liquid-rocketry-illinois/HAL-1-GND/KC_proj/KC_proj.kicad_pcb

## KiCad design KC_proj/KC_proj.kicad_pcb (2026-05-08)

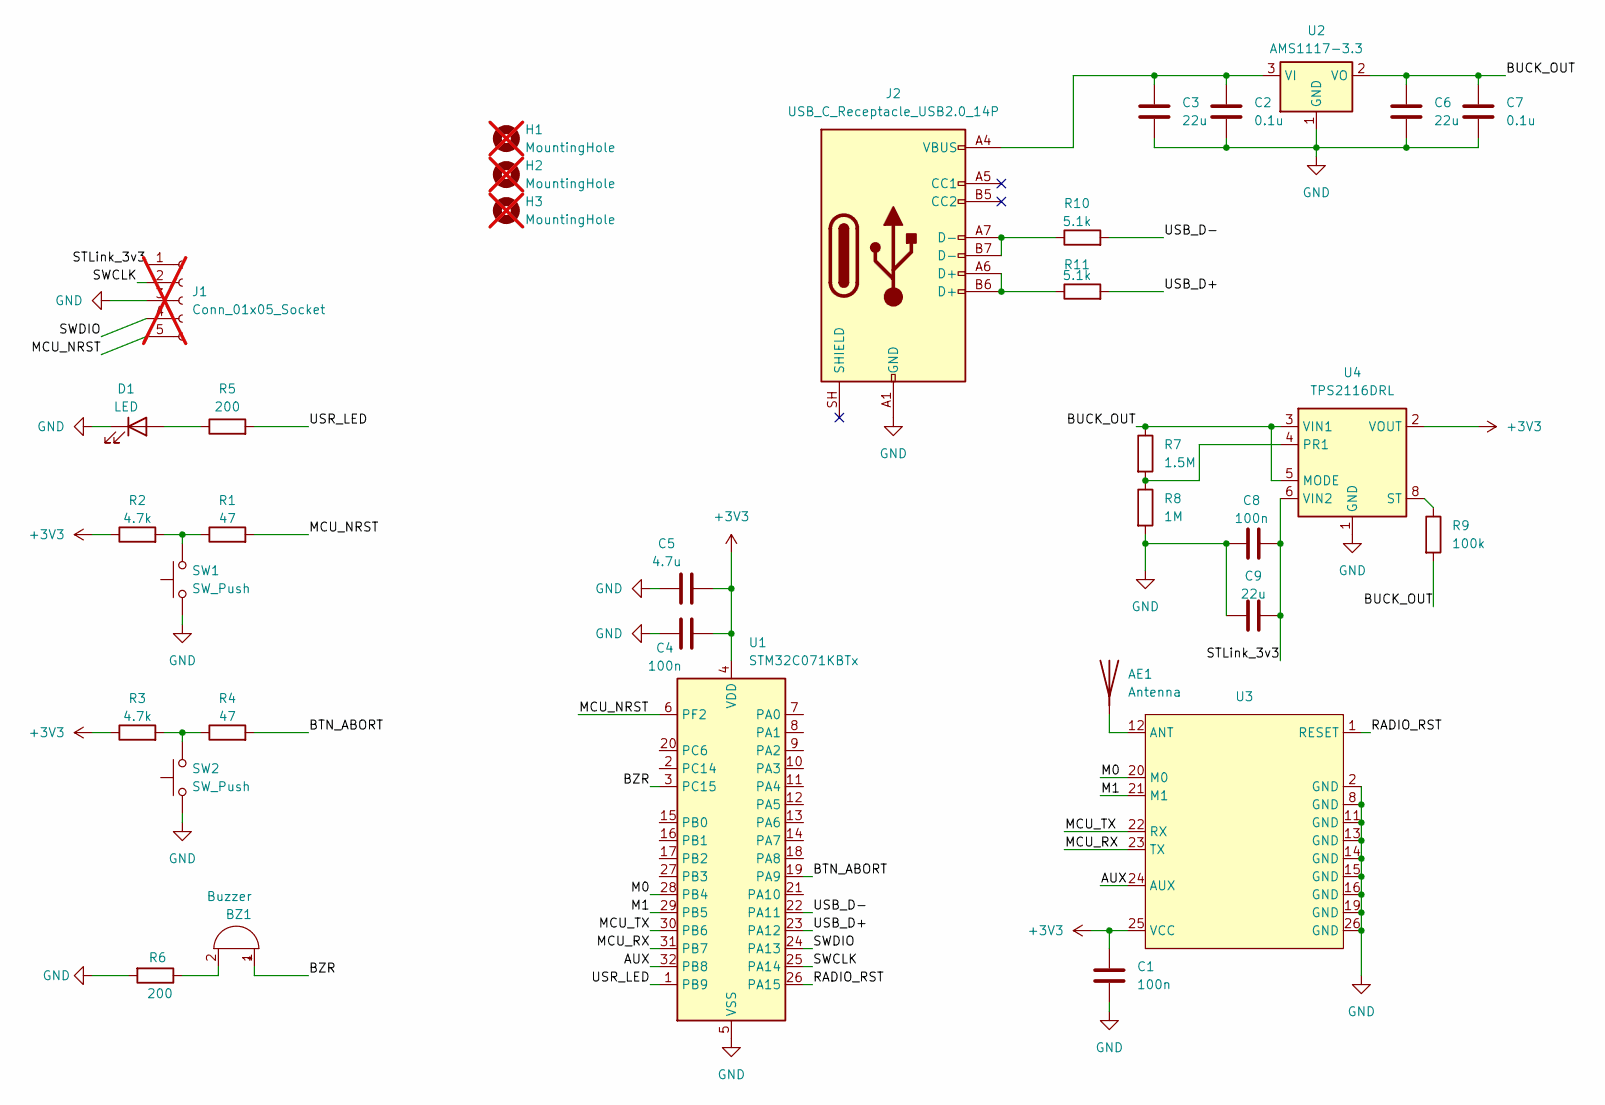
[picture p1: schematic KC_proj.kicad_sch]

Parts:
AE1: Antenna; SMA_Amphenol_901-143_Horizontal
BZ1: Buzzer; Buzzer_12x9.5RM7.6
C1, C4, C8: 100n; C_0603_1608Metric
C2, C7: 0.1u; C_0603_1608Metric
C3, C6, C9: 22u; C_0603_1608Metric
C5: 4.7u; C_0603_1608Metric
D1: LED; LED_0603_1608Metric
H1, H2, H3: MountingHole; MountingHole_2.2mm_M2; not fitted
J1: Conn_01x05_Socket; PinHeader_1x05_P2.54mm_Vertical; not fitted
J2: USB_C_Receptacle_USB2.0_14P; USB_C_Receptacle_HRO_TYPE-C-31-M-12
R1, R4: 47; R_0603_1608Metric
R2, R3: 4.7k; R_0603_1608Metric
R5, R6: 200; R_0603_1608Metric
R7: 1.5M; R_0603_1608Metric
R8: 1M; R_0603_1608Metric
R9: 100k; R_0603_1608Metric
R10, R11: 5.1k; R_0603_1608Metric
SW1, SW2: SW_Push; SW_Push_1P1T_NO_CK_KSC6xxJ
U1: STM32C071KBTx; LQFP-32_7x7mm_P0.8mm
U2: AMS1117-3.3; SOT-223-3_TabPin2
U3: E22-900T22S
U4: TPS2116DRL; SOT-583-8

Connections:
+3V3: C1.1, C4.2, C5.2, R2.1, R3.1, U1.4 (VDD), U3.25 (VCC), U4.2 (VOUT), U4.7 (VOUT)
/AUX: U1.32 (PB8), U3.24 (AUX)
/BTN_ABORT: R4.2, U1.19 (PA9)
/BUCK_OUT: C6.1, C7.1, R7.1, R9.2, U2.2 (VO), U4.3 (VIN1), U4.5 (MODE)
/BZR: BZ1.1 (+), U1.3 (PC15)
/M0: U1.28 (PB4), U3.20 (M0)
/M1: U1.29 (PB5), U3.21 (M1)
/MCU_NRST: J1.5, R1.2, U1.6 (PF2)
/MCU_RX: U1.31 (PB7), U3.23 (TX)
/MCU_TX: U1.30 (PB6), U3.22 (RX)
/RADIO_RST: U1.26 (PA15), U3.1 (RESET)
/STLink_3v3: C8.2, C9.2, J1.1, U4.6 (VIN2)
/SWCLK: J1.2, U1.25 (PA14)
/SWDIO: J1.4, U1.24 (PA13)
/USB_D+: R11.2, U1.23 (PA12)
/USB_D-: R10.2, U1.22 (PA11)
/USR_LED: R5.2, U1.1 (PB9)
GND: C1.2, C2.2, C3.2, C4.1, C5.1, C6.2, C7.2, C8.1, C9.1, D1.1 (K), J1.3, J2.A1 (GND), J2.A12 (GND), J2.B1 (GND), J2.B12 (GND), R6.2, R8.2, SW1.1, SW2.1, U1.5 (VSS), U2.1 (GND), U3.2 (GND), U3.8 (GND), U3.11 (GND), U3.13 (GND), U3.14 (GND), U3.15 (GND), U3.16 (GND), U3.19 (GND), U3.26 (GND), U4.1 (GND)
unnamed: AE1.1 (A_1), U3.12 (ANT)
unnamed: BZ1.2 (-), R6.1
unnamed: D1.2 (A), R5.1
unnamed: J2.A6 (D+), J2.B6 (D+), R11.1
unnamed: J2.A7 (D-), J2.B7 (D-), R10.1
unnamed: R1.1, R2.2, SW1.2
unnamed: R3.2, R4.1, SW2.2
unnamed: C2.1, C3.1, J2.A4 (VBUS), J2.A9 (VBUS), J2.B4 (VBUS), J2.B9 (VBUS), U2.3 (VI)
unnamed: R7.2, R8.1, U4.4 (PR1)
unnamed: R9.1, U4.8 (ST)

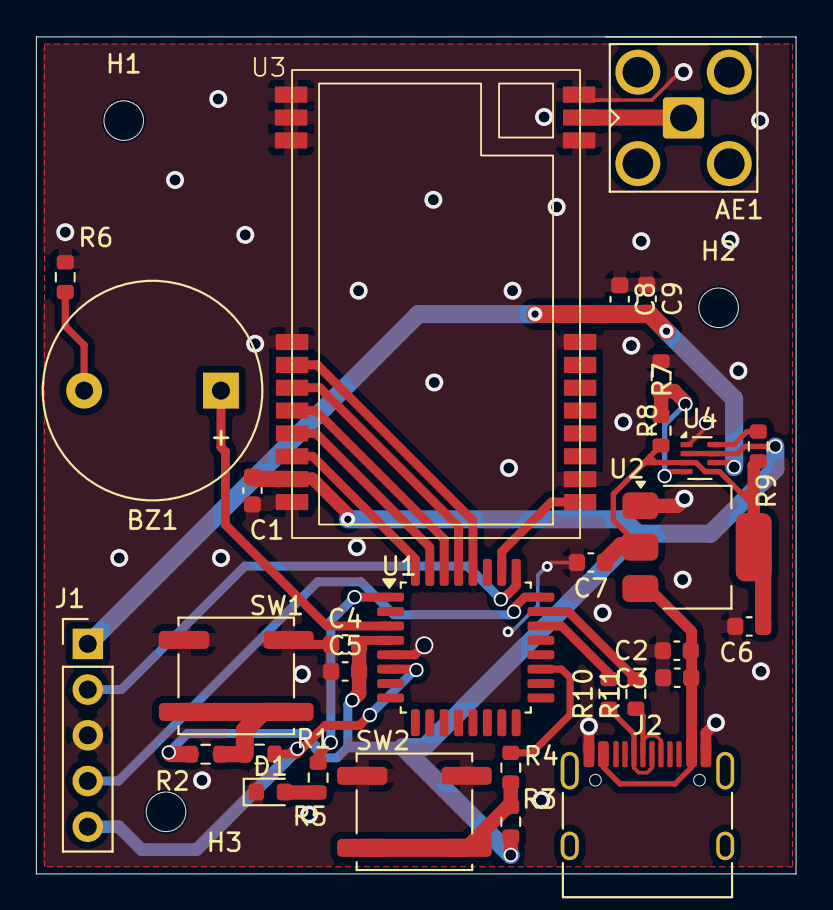
[picture p2: board KC_proj.kicad_pcb from above]

Board: 2 copper layers, 42.2 x 46.5 mm, 34 parts (0 on the bottom side), 28 nets.
