liquid-rocketry-illinois/HAL-1-GND/Code/Core/Inc/main.h

#define USR_LED_Pin GPIO_PIN_9
#define USR_LED_GPIO_Port GPIOB
#define BZR_Pin GPIO_PIN_15
#define BZR_GPIO_Port GPIOC
#define MCU_NRST_Pin GPIO_PIN_2
#define MCU_NRST_GPIO_Port GPIOF
#define BTN_ABORT_Pin GPIO_PIN_9
#define BTN_ABORT_GPIO_Port GPIOA
#define RADIO_RST_Pin GPIO_PIN_15
#define RADIO_RST_GPIO_Port GPIOA
#define RADIO_M0_Pin GPIO_PIN_4
#define RADIO_M0_GPIO_Port GPIOB
#define RADIO_M1_Pin GPIO_PIN_5
#define RADIO_M1_GPIO_Port GPIOB
#define MCU_TX_Pin GPIO_PIN_6
#define MCU_TX_GPIO_Port GPIOB
#define MCU_RX_Pin GPIO_PIN_7
#define MCU_RX_GPIO_Port GPIOB
#define RADIO_AUX_Pin GPIO_PIN_8
#define RADIO_AUX_GPIO_Port GPIOB
