liquid-rocketry-illinois/HAL-1-GND/Code/Core/Inc/DataHandling.h

//
// Created by dyrel on 5/13/2026.
//

#ifndef CODE_DATAUPDATING_H
#define CODE_DATAUPDATING_H

#include "Radio.h"
#include "main.h"

void Update_Local_Data();
// In future could add some simple logic to get position, velocity, acceleration.
// For the CTRL-FRK flight we're focusing on roll.

#endif //CODE_DATAUPDATING_H
