liquid-rocketry-illinois/HAL-1-GND/(commit log)

2026-04-24 Upload kicad stuff
    [KC_proj.kicad_pcb, KC_proj.kicad_sch]
2026-04-24 wire kicad diags
    [KC_proj.kicad_sch]
2026-05-01 Remake Cmake project with new MCU. Finish PCB Design v1 for review.
    [BOM-KC_proj.csv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]
2026-05-01 Make mounting holes excluded
    [CPL-KC_proj.csv, KC_proj-CuBottom.gbr, KC_proj-CuIn1.gbr, KC_proj-CuIn2.gbr, KC_proj-CuTop.gbr, KC_proj-EdgeCuts.gbr, KC_proj-MaskBottom.gbr, KC_proj-MaskTop.gbr]
2026-05-08 Update libs and kicad
    [BOM-KC_proj.csv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]
2026-05-15 check tusb
    [STM32c071.cfg]
2026-05-23 Update structure, resolve RCI connection issue
    [Ebyte_E22_900T22S.cpp, Ebyte_E22_900T22S.h, Ebyte_E22_900T22S_defs.h, RADIO_DEFNS.h, Radio.cpp, Radio.h, main.cpp]
2026-05-24 Fix RSSI byte position in config
    [Ebyte_E22_900T22S_defs.h, Radio.cpp]
2026-06-01 Fix radio packet byte reception issue
    [Ebyte_E22_900T22S.cpp]
2026-06-04 Update servo actuation data transceive
2026-06-08 update sending logic for longer bursts and fewer interrupts to fc
2026-06-12 Fix RSSI Local byte to output RSSI during data recieve
    [Ebyte_E22_900T22S.cpp, Radio.cpp, Radio.h]
